3p3r/bss/System Design and Modeling/Level0_SystemBlockDiagram.pdf

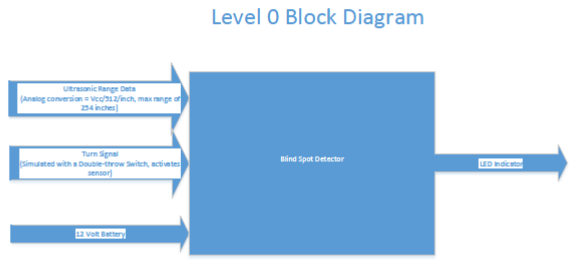
[picture p1: figure]

Module | Level 0 System
Inputs | - Ultrasonic range data, analog voltage converted to distance, (Vcc/512)/inch
| - Turn signal, simulated with a double -throw switch
| - 12 volt car battery
Output | - LED Indicator
Functionality | Detector will light the LED based on a certain analog voltage received from the sensor and a 5 volt output from the NMOS voltage buffer. This LED indicates to the user that there is an object detected in the blind spot range while the user is signaling a turn.
