3p3r/bss/System Design and Modeling/UML_InteractionView.pdf

1: Turn Car On (12 Volts DC) → 2: Turn Signal On (Logic
High) →
- 3: Alert User (LED Logic High)
- 4: Analog Range Data
(9.8mV/inch)

# Blind Spot Detector Interaction View
