3p3r/bss/System Design and Modeling/Level 0 Sub Systems/Level0_12VoltBattery.pdf

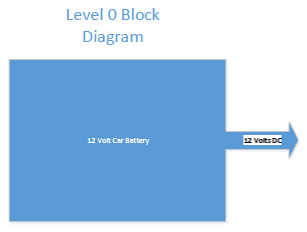
[picture p3: figure]

Module | 12 Volt Car Battery
Input | N/A
Output | 12 Volts DC
Functionality | Provides convenient power to the circuit through the 5 volt regulator
