3p3r/bss/System Design and Modeling/Level 0 Sub Systems/Level0_UltrasonicSensor.pdf

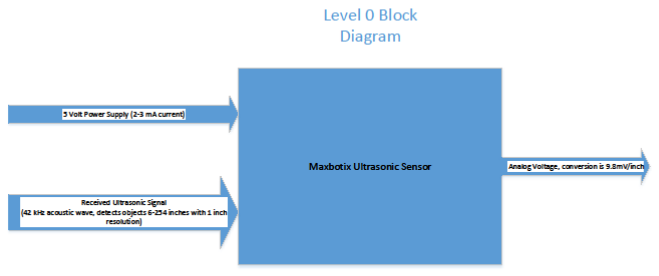
[picture p5: figure]

Module | Maxbotix Ultrasonic Sensor
Inputs | -5 Volt Power Supply from regulator -Received ultrasonic signal, 42 kHz
| acoustic waves
Output | - Analog Voltage at 9.8mV/inch
Functionality | Provides object detection distance via analog voltage output to 8 -bit AVR microcontroller
