3p3r/bss/System Design and Modeling/UML_StateMachineView.pdf

# Blind Spot Detector State Machine View

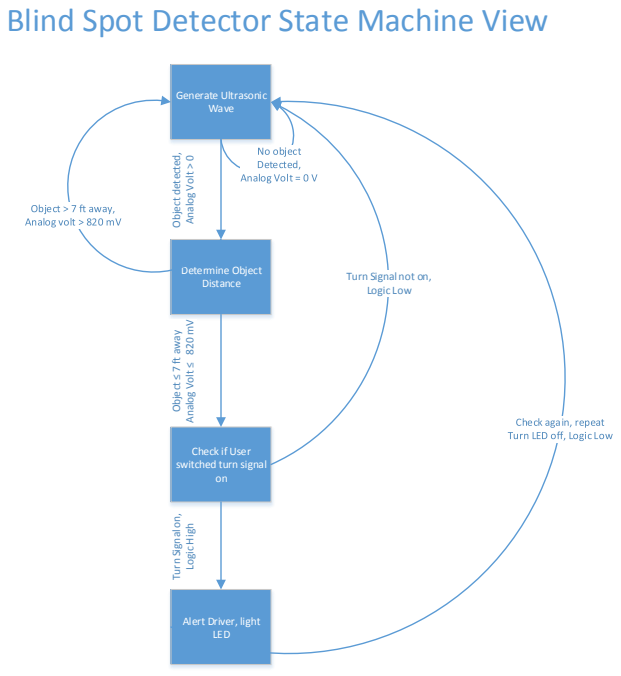
[picture p6: page 1]
Generate Ultrasonic Wave; Determine Object Distance; Object detected,; Analog Volt > 0; Logic High

Turn Signal not on,
Logic Low

Analog Volt ≤ 820 mV

Object ≤ 7 ft away

Check if User
switched turn signal

Turn Signal on,

Alert Driver, light
LED
