3p3r/bss/CAD/BSD Final Design.brd

## EAGLE design CAD/BSD Final Design.brd (2015-12-09)

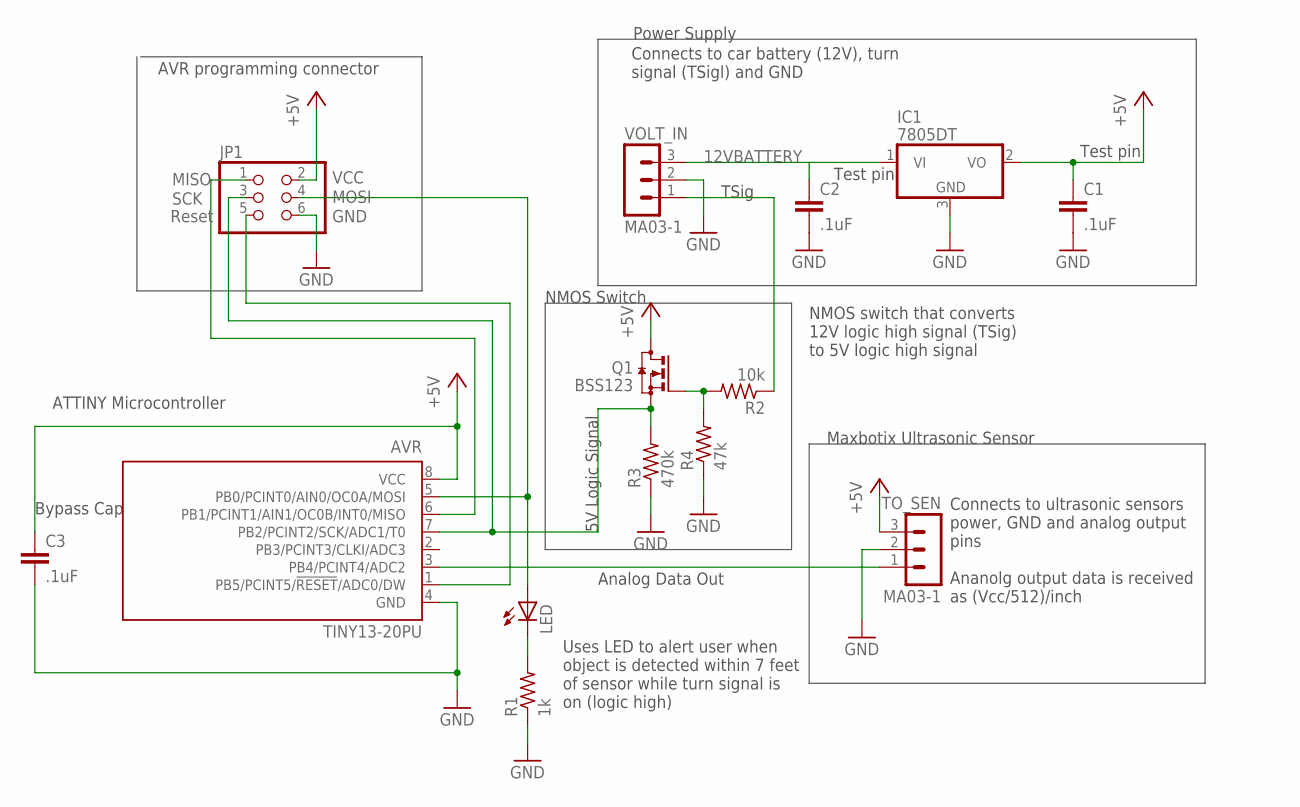
[picture p7: schematic BSD Final Design.sch]

Parts:
AVR: TINY13-20PU; DIL08
C1, C2, C3: .1uF; C0805
IC1: 7805DT; TO252
JP1: PINHD-2X3; 2X03
LED: LED5MM
Q1: BSS123; SOT23
R1: 1k; R0805
R2: 10k; R0805
R3: 470k; R0805
R4: 47k; R0805
TO_SEN: MA03-1
VOLT_IN: MA03-1

Connections:
2N7000: AVR.7 (PB2/PCINT2/SCK/ADC1/T0), JP1.3, Q1.2 (S), R3.2
12VBATTERY: C2.1, IC1.1 (VI), VOLT_IN.3
+5V: AVR.8 (VCC), C1.1, C3.1, IC1.2 (VO), JP1.2, Q1.3 (D), TO_SEN.3
GND: AVR.4 (GND), C1.2, C2.2, C3.2, IC1.3 (GND), JP1.6, R1.1, R3.1, R4.1, TO_SEN.2, VOLT_IN.2
unnamed: AVR.3 (PB4/PCINT4/ADC2), TO_SEN.1
unnamed: AVR.5 (PB0/PCINT0/AIN0/OC0A/MOSI), JP1.4, LED.A
unnamed: R2.1, VOLT_IN.1
unnamed: Q1.1 (G), R2.2, R4.2
unnamed: AVR.1 (PB5/PCINT5/!RESET!/ADC0/DW), JP1.5
unnamed: AVR.6 (PB1/PCINT1/AIN1/OC0B/INT0/MISO), JP1.1
RLED: LED.K (C), R1.2

Notes on the sheet:
Bypass Cap
Power Supply
Connects to ultrasonic sensors power, GND and analog output pins Ananolg output data is received as (Vcc/512)/inch
Connects to car battery (12V), turn signal (TSigl) and GND
ATTINY Microcontroller
Test pin
MISO
SCK
Reset
VCC
MOSI
GND
AVR programming connector
Uses LED to alert user when object is detected within 7 feet of sensor while turn signal is on (logic high)
NMOS switch that converts 12V logic high signal (TSig) to 5V logic high signal
NMOS Switch
Maxbotix Ultrasonic Sensor
Analog Data Out
TSig
5V Logic Signal

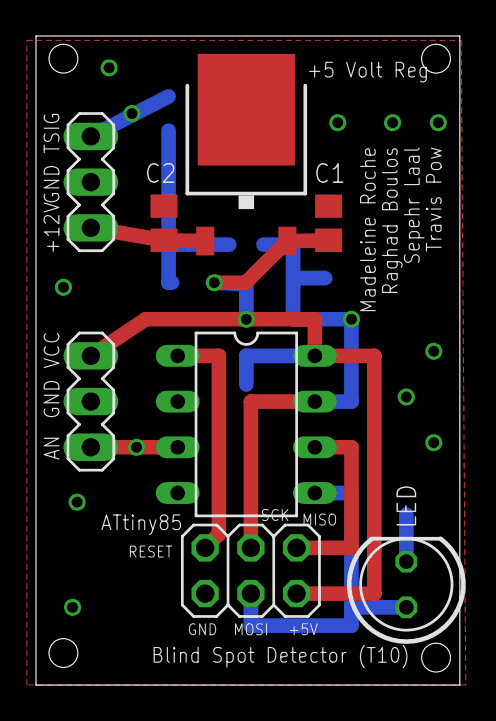
[picture p8: board BSD Final Design.brd from above]

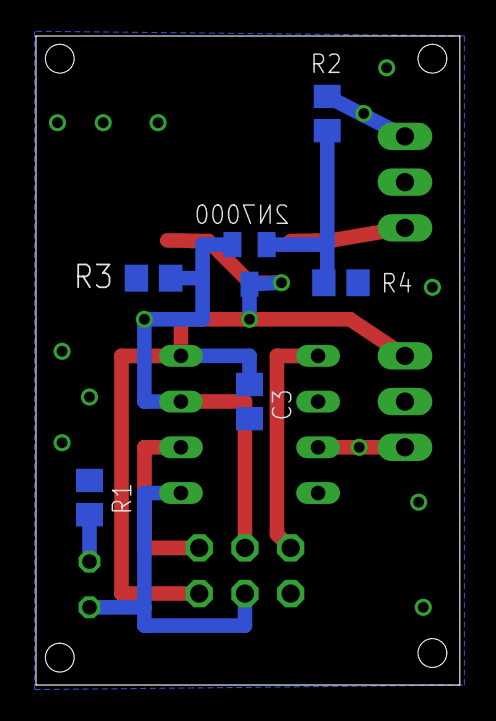
[picture p9: board BSD Final Design.brd from below]

Board: 2 copper layers, 23.5 x 36.1 mm, 14 parts (6 on the bottom side), 11 nets.
