3p3r/bss/Revised Test Plan.docx

Blind Spot Detector Test Plan

Authors: Travis Pow, Madeleine Roche,

Raghad Boulos, Sepehr Laal

Revision History: BSD Test Plan 1.1

Revision Date: 12/8/2015

1. Blind Spot Detector (BSD)
  1.1. Design Documentation
    1.1.1. BSD System Specifications
    1.1.2. BSD System Requirements
    1.1.3. BSD Block Level Diagram
    1.1.4. BSD Schematic
    1.1.5. BSD PCB Layout
    1.1.6. BSD Software
2. Equipment and materials required
  2.1. Blind Spot Detector
  2.2. Vehicle
  2.3. Person
  2.4. Bicycle
  2.5. Multimeter
  2.6. Environmental chamber
  2.7. Measuring tape
  2.8. Protractor
  2.9. Thermometer
  2.10. Oscilloscope
  2.11. Mechanic to Install Blind Spot Detector
3. Installation Test
  3.1. Mechanic required for installation
4. Environmental Test
  4.1. Temperature
  4.2. Humidity
  4.3. Rain
  4.4. Snow
  4.5. Hail
  4.6. Altitude
5. Use Test
  5.1. Object detection while stationary
    5.1.1. Vehicle
    5.1.2. Biker
    5.1.3. Pedestrian
  5.2. Object detection while moving
    5.2.1. Vehicle
    5.2.2. Biker
    5.2.3. Pedestrian
6. Stress Testing
  6.1. Accuracy in extreme weather conditions
    6.1.1. Heat
    6.1.2. Cold
    6.1.3. Rain
    6.1.4. Snow
    6.1.5. Hail
  6.2. Accuracy at freeway speeds
  6.3. Accuracy in a noisy environment
7. Module Tests
  7.1. Maxbotix Ultrasonic Sensor
  7.2. BSD Processor
8. Parametric Test
  8.1. Detection time
  8.2. Power Consumption
9. Exhaustive Testing
  9.1. With turn signal off
    9.1.1. Object within 7 feet of sensor
    9.1.2. No object within 7 feet of sensor
  9.2. With turn signal on
    9.2.1. Object within 7 feet of sensor
    9.2.2. No object within 7 feet of sensor
10. Object Detection Tests
  10.1. Range of Detection
    10.1.1. Maxbotix Ultrasonic Sensor: Max/min distance object can be detected
      10.1.1.1. Various size of object at room temperature in ideal condition
        10.1.1.1.1. Vehicle
        10.1.1.1.2. Biker
        10.1.1.1.3. Person
      10.1.1.2. Various outdoor temperatures
        10.1.1.2.1. 35 degrees Celsius
        10.1.1.2.2. -40 degrees Celsius
      10.1.1.3. Various levels of humidity
        10.1.1.3.1. High humidity
        10.1.1.3.2. Low humidity
      10.1.1.4. During rain
        10.1.1.4.1. Light rain
        10.1.1.4.2. Heavy rain
      10.1.1.5. Snowy conditions
        10.1.1.5.1. Snowing
          10.1.1.5.1.1. With snow on ground
          10.1.1.5.1.2. Without snow on ground
        10.1.1.5.2. Not snowing with snow on ground
    10.1.2. Maxbotix Ultrasonic Sensor: Width of beam width
      10.1.2.1. Various outdoor temperatures
        10.1.2.1.1. 35 degrees Celsius
        10.1.2.1.2. -20 degrees Celsius
      10.1.2.2. Various levels of humidity
        10.1.2.2.1. High humidity
        10.1.2.2.2. Low humidity
      10.1.2.3. During rain
        10.1.2.3.1. Light rain
        10.1.2.3.2. Heavy rain
      10.1.2.4. Snowing
    10.1.3. Software (AVR ATtiny85): Determine accuracy of distance measurement with set distance on ATtiny 85)
      10.1.3.1. Various size of object at room temperature in ideal condition
        10.1.3.1.1. Vehicle
        10.1.3.1.2. Biker
        10.1.3.1.3. Person
      10.1.3.2. Various outdoor temperatures
        10.1.3.2.1. 35 degrees Celsius
        10.1.3.2.2. -40 degrees Celsius
      10.1.3.3. Various levels of humidity
        10.1.3.3.1. High humidity
        10.1.3.3.2. Low humidity
      10.1.3.4. During rain
        10.1.3.4.1. Light rain
        10.1.3.4.2. Heavy rain
      10.1.3.5. Snowy conditions
        10.1.3.5.1. Snowing
          10.1.3.5.1.1. With snow on ground
          10.1.3.5.1.2. Without snow on ground
        10.1.3.5.2. Not snowing with snow on ground
      10.1.3.6. Software (AVR ATtiny85): Stability of detection indication
        10.1.3.6.1. Object near max detection
        10.1.3.6.2. Object near min detection
    10.1.4. Detection time of Blind Spot Detector (whole system)
      10.1.4.1. When turn signal is on
      10.1.4.2. When turn signal is off
11. Durability Tests
  11.1. Operating temperature
    11.1.1. Max temperature
      11.1.1.1. 85 degrees Celsius
    11.1.2. Min temperature
      11.1.2.1. -40 degrees Celsius
    11.1.3. Degree of humidity
      11.1.3.1. High humidity
      11.1.3.2. Low humidity
    11.1.4. Rain
    11.1.5. Snow
    11.1.6. Hail
    11.1.7. Collisions
      11.1.7.1. Small object projectiles/collisions
      11.1.7.2. Larger object projectiles/collisions
    11.1.8. Input voltage variations due to car battery inconsistencies
      11.1.8.1. Test functional range of 14V < Voltage In < 6V
12. System power requirements measurements
  12.1. Power consumption
    12.1.1. Sensor
    12.1.2. AVR ATtiny
    12.1.3. LED
    12.1.4. Voltage regulator
    12.1.5. NMOS switch
    12.1.6. Resistors
    12.1.7. Capacitors
    12.1.8. System as a whole
  12.2. Current consumption
    12.2.1. No object detected
    12.2.2. Object detected
      12.2.2.1. Outside of set max distance (no user alert)
      12.2.2.2. Within set max distance (user alert)
