3p3r/bss/(commit log)

2015-12-09 CAD to master
    [BSD Final Design.brd, BSD Final Design.sch]
2015-12-11 BOM commit
